dhanjit/vertical-chess-board/README.md

# Vertical Wall Chess Board

A chess board that **hangs on the living-room wall** like art and plays
vertically — with two signature mechanics:

- 🔄 **Rotates 180° based on whose turn it is**, so the player to move always
  sees the board from their own side.
- 🌍 **Pieces stay upright by gravity** — each piece hangs on a pivot and is
  bottom-heavy *by shape* (solid below the pivot, hollow above it — nothing
  glued in), so as the board turns, every piece self-levels and is never
  upside-down.
- 🧲 **Magnetic pieces** grip a steel-sheet vertical playing face.
- 🎛️ **The piece design is a *choice*, not one answer** — two piece styles and
  two ways of hanging them sit side by side in the repo, each a one-line
  selector, and more can be added. Compared measure-for-measure in
  [`docs/PIECE_DESIGNS.md`](docs/PIECE_DESIGNS.md).
- 🖨️ **3-D printable** — parametric models, ready for any FDM printer.
- 🌠 **Aspirational (later):** the board plays *you* (auto-mover) and is
  controllable from a phone app — researched, but deliberately out of the
  initial focus. The near-term goal is the hand-played manual board.

This repo is the **single source of truth** for building it: designs, models,
electronics, the game brain, and the plan.

## Repo map

```
README.md              ← you are here
CLAUDE.md              ← context for AI sessions working on this repo
docs/
  OVERVIEW.md          ← ⭐ one-page what / why / how + the plan (share this)
  START_HERE.md        ← new to printing? plain-language first steps + print spec
  PROJECT_REVIEW.md    ← honest review of the idea + re-scoped beginner plan
  SOURCING_BANGALORE.md← where to print + buy parts locally (₹)
  OPEN_SOURCE.md       ← existing open-source projects to reuse (don't reinvent)
  AUTO_MOVER_ANALYSIS.md← why a vertical self-moving board is hard (physics)
  AUTO_MOVER_DESIGN.md ← how to actually build one (EPM matrix, prior art, prototypes)
  DESIGN.md            ← how it works (the two mechanics, magnets, sensing)
  PIECE_DESIGNS.md     ← the piece variants side by side — open this to choose
  GOALS.md             ← vision, phases, roadmap, decisions to lock
  BOM.md               ← shopping list per phase
  BUILD_GUIDE.md       ← step-by-step assembly (start at Phase 0!)
  ELECTRONICS.md       ← powered rotation, sensing, auto-mover, firmware plan
hardware/              ← parametric OpenSCAD models (+ Makefile → STLs)
  common.scad          ← ⭐ edit this to resize the whole board; holds the two
                          variant selectors (piece_style, pivot_type)
  gravity_gimbal.scad  ← the self-righting pivot — ALL the architectures
  pieces.scad          ← the mechanism that turns a silhouette into a piece
  styles/              ← the artwork: one file per piece style
    monolith.scad      ←   an invented design language
    familiar.scad      ←   the vocabulary everyone knows (default)
  board_panel.scad     ← 8×8 surface: steel-sheet face + hall-sensor bores
  frame.scad           ← bezel
  rotation_hub.scad    ← wall plate + turntable + drive
software/engine/       ← the brain (plain JS, no deps)
  chess.js             ← full rules engine (perft-verified)
  ai.js                ← negamax + alpha-beta opponent
app/                   ← control-app spec (future)
```

## Start here

**Want the whole project on one page?** Read
[`docs/OVERVIEW.md`](docs/OVERVIEW.md) — what it is, why we're building it, and
the plan. It's the doc to share with anyone new, including whoever prints the
parts.

**New to 3D printing / electronics? Read [`docs/START_HERE.md`](docs/START_HERE.md)
next** — a plain-language guide (no experience needed) with a print spec for
whoever runs the printer and a simple shopping list. Then
[`docs/PROJECT_REVIEW.md`](docs/PROJECT_REVIEW.md) reviews the idea and lays
out a realistic staged plan, and [`docs/SOURCING_BANGALORE.md`](docs/SOURCING_BANGALORE.md)
covers where to print and buy parts in Bengaluru.

Then, when you want the deeper detail:
1. [`docs/DESIGN.md`](docs/DESIGN.md) — the concept and mechanics.
2. [`docs/GOALS.md`](docs/GOALS.md) — phases and the decisions to lock.
3. **Phase 0** in [`docs/BUILD_GUIDE.md`](docs/BUILD_GUIDE.md): print one
   gravity gimbal + one piece and prove the self-righting magnet mechanic
   before committing to a full set.

## Status

| Area | State |
|---|---|
| Rules engine + AI | ✅ implemented, perft-verified (20 / 400 / 8902) |
| Parametric models (pieces, gimbal, panel, frame, hub) | ✅ drafted, ready to render/tune |
| Docs (design, goals, BOM, build, electronics) | ✅ drafted |
| Anything physically built | ⬜ over to Phase 0 |

Phased so **Phase 1 alone is a complete, beautiful manual board** you can hang
and play; later phases add powered rotation and sensing, and — aspirationally —
an auto-mover and app, without a rebuild.

## Building the STLs

```
cd hardware && make          # needs OpenSCAD; outputs to hardware/stl/
```

## Using the brain

```
node -e 'const {Chess}=require("./software/engine/chess.js"); const g=new Chess(); console.log(g.legalMoves().length)'   # 20
```
