dhanjit/vertical-chess-board/docs/OVERVIEW.md

# Project Overview — Vertical Wall Chess Board

**One page: what this is, why we're building it, how it works, and the plan to
get there.** If you're new to the project — or about to print the parts — read
this first. Everything else in the repo is detail that hangs off this page.

---

## What it is

A real chess board that **hangs on the living-room wall like a piece of art**
and plays vertically. Three things make it special:

- 🔄 **It rotates 180° to face whoever's turn it is** — the player to move
  always sees the board from their own side.
- 🌍 **Pieces stay upright by gravity** — each piece hangs on a pivot and is
  bottom-heavy *by shape* (solid below the pivot, hollow above it), so as the
  board turns, every piece self-levels like a pendulum and is never
  upside-down.
- 🧲 **Pieces are magnetic** — they grip the board's vertical steel face, so
  they hold on and slide square to square.

It's **3-D printed** from parametric models (a few numbers resize the whole
board) plus a short list of off-the-shelf parts — magnets, a thin steel
sheet, a turntable bearing, a wall cleat.

## Why we're building it

- A chess board that's also **wall art** — quietly beautiful when idle,
  a little bit magical in play.
- The combination — **face-the-player rotation** *and* **gravity-upright
  pieces** on a **vertical** board — is genuinely new. Smart/auto boards on the
  market lie flat; none do the self-righting wall trick.
- It's an achievable, satisfying **making project**. The first version needs
  **no electronics and no coding** — just printed parts, magnets, and glue —
  so it's a real object on the wall long before any of the fancy stuff.

## How it works (30 seconds)

<p align="center">
  The two signature mechanics. Left: the board rotates 180 degrees each turn on a central turntable, so the player to move always sees it from their side. Right: each piece hangs on a pivot with a heavy base, so gravity keeps it upright like a pendulum however the board is turned.
</p>

- The board is a **vertical plane on a central turntable**. Its playing face
  is a **thin steel sheet**, and a **magnet** grips it directly, so pieces hold
  on and glide square to square — the same hold every commercial magnetic wall
  set uses. In the default arrangement that magnet sits in a small printed
  **hub puck** behind the piece, under a **felt disc**; the alternative puts it
  inside the piece itself (next bullet).
- Each piece body hangs on a **low-friction pivot** and is **solid below that
  pivot and hollow above it** — a pendulum that always points up, no matter how
  the board is turned. Nothing is glued or weighted into a piece.
- **The piece design is a *choice*, not a single answer.** Two piece styles
  (what a piece **looks like**) and two ways of hanging them (where the
  **magnet** lives) are kept in the repo side by side, selectable with one line
  each, and more approaches are expected. The defaults — the familiar-looking
  set on a hub-puck pivot — are what the rest of this page describes. If you're
  deciding what to print, the comparison is
  [`PIECE_DESIGNS.md`](PIECE_DESIGNS.md).
- *(Later, optionally)* a motor spins the board, hall sensors behind each
  square read the position, and the built-in chess engine follows and
  validates the game.

<p align="center">
  Cross-section through one square. A magnet in the piece hub, capped with a felt disc, grips the thin steel sheet directly, holding the piece on the vertical board. A small hole in the sheet at the square's centre is open air, so a hall sensor sitting flush in the printed wall behind it reads the pi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
</p>

Full engineering detail: [`DESIGN.md`](DESIGN.md).

---

## The plan — how we get there

Build in **phases**, and **each phase is a complete, usable thing on its own**.
You can stop after any of them and have something real.

```mermaid
flowchart LR
    P0["<b>Phase 0</b><br/>Prove the magic<br/><i>~1 evening · ~₹500</i>"]
    P1["<b>Phase 1</b> ⭐<br/>Manual wall board<br/><i>hang &amp; play by hand</i>"]
    P2["<b>Phase 2</b><br/>Powered rotation<br/>+ sensing"]
    P3["<b>Phase 3</b><br/>Board plays you<br/>(auto-mover)"]
    P4["<b>Phase 4</b><br/>App &amp; polish"]
    P0 --> P1 --> P2 -.-> P3 -.-> P4
    P1 -. "stop here &amp;<br/>be delighted" .-> DONE([complete board])
    classDef focus fill:#1a7f37,stroke:#0d4020,color:#ffffff;
    classDef optional fill:#9a6700,stroke:#5c3d00,color:#ffffff;
    classDef asp fill:#8250df,stroke:#432c85,color:#ffffff;
    classDef done fill:#eaf6ee,stroke:#1a7f37,color:#0d4020;
    class P0,P1 focus;
    class P2 optional;
    class P3,P4 asp;
    class DONE done;
```

**Legend:** 🟩 focused on now · 🟧 optional, later · 🟪 aspirational (parked).
Solid arrows are the path we're building; dotted ones are further out.

| Phase | What you get | Where it sits |
|---|---|---|
| **Phase 0 — Prove the magic** | Print *one* pivot + *one* piece; confirm a piece **sticks** to a vertical steel surface and **stays upright** when you spin it. ~1 evening, ~₹500. | ✅ **do this first** — a GO/NO-GO gate before printing a whole set |
| **Phase 1 — Manual wall board** ⭐ | The full 32-piece set + board panel + frame + turntable, hung on the wall and **spun by hand** each turn. No electronics, no code. | 🎯 **this is the goal we're focused on** — and, for most people, the finished project |
| **Phase 2 — Powered + sensing** | A motor rotates the board on a button press; hall sensors read the pieces so the board follows the game and flags illegal moves. Your first electronics. | 🟡 optional, later |
| **Phase 3 — The board plays you** | An auto-mover physically moves its own pieces and plays you (via Stockfish). | 🌠 **aspirational — not a current focus** (see below) |
| **Phase 4 — App & polish** | Phone app: difficulty, hints, clocks, online play, sound/LED. | 🌠 aspirational — later |

> Two docs expand this same path: [`PROJECT_REVIEW.md`](PROJECT_REVIEW.md)
> breaks it into finer beginner **stages A–E** with an honest difficulty/risk
> read, and [`GOALS.md`](GOALS.md) is the full technical roadmap with the open
> design decisions. This table is the summary they both detail.

---

## What we're focused on right now

**Focus: get to a hung, hand-played manual board (Phase 0 → Phase 1).** That is
a complete, beautiful object and, for most builders, the whole project. The
near-term repo work — printable parts, BOM, build steps — all serves this.

**Aspirational — deliberately *not* the current focus:**

- **The auto-mover** (Phase 3 — a board that moves its own pieces and plays
  you). On a *vertical* board this is genuinely hard: the steel sheet that
  **holds** pieces up also **shields** the magnet that would **move** them, so
  it's a **different machine**, not a bolt-on. We've researched *how* it could
  work and *why* it's hard — [`AUTO_MOVER_ANALYSIS.md`](AUTO_MOVER_ANALYSIS.md)
  (the why) and [`AUTO_MOVER_DESIGN.md`](AUTO_MOVER_DESIGN.md) (the how) — and
  we're parking it as a **someday** goal.
- **The phone app** (Phase 4) is a similarly later, aspirational add.

**Good news:** nothing built for Phase 1 is wasted if auto-play is ever
pursued — the pieces, the chess brain, and most of the frame carry straight
over. So there's no penalty for building the manual board first and deciding on
the rest later.

---

## If you're the one printing the parts

You don't need to understand the whole project to print — but if you want the
context (what this is, why, what you're printing toward), it's right here:

1. **This page** — what it is, why we're building it, and the plan *(the what &
   why)*.
2. [`../hardware/README.md`](../hardware/README.md) — how to turn the `.scad`
   models into STLs, and the print settings *(the how)*.
3. [`START_HERE.md`](START_HERE.md) — a plain-language, **no-experience-needed**
   walk-through, including a **print spec** (what to render first) and the
   small shopping list.

```mermaid
flowchart TD
    A["📖 <b>OVERVIEW.md</b><br/><i>what · why · the plan</i>"]
    A --> B["🖨️ <b>hardware/README.md</b><br/><i>render STLs + print settings</i>"]
    A --> C["🌱 <b>START_HERE.md</b><br/><i>plain-language walkthrough</i>"]
    B --> D(["Print a <b>test batch</b><br/>1 gimbal + 1 pawn"])
    C --> D
    D --> E(["Prove it → print the full set"])
    classDef hub fill:#0969da,stroke:#0a3069,color:#ffffff;
    classDef step fill:#eef2f6,stroke:#57606a,color:#1f2328;
    classDef goal fill:#eaf6ee,stroke:#1a7f37,color:#0d4020;
    class A hub;
    class B,C step;
    class D,E goal;
```

**Short version:** render a **test batch first** — one gravity gimbal + one
**pawn** (the cheapest print in the set) — prove the piece sticks and
self-rights, *then* print the full set.

---

## The rest of the repo, at a glance

| Doc | What's in it |
|---|---|
| [`START_HERE.md`](START_HERE.md) | Plain-language first steps + print spec (start here if you're new to printing) |
| [`DESIGN.md`](DESIGN.md) | How the two mechanics, magnets, and sensing actually work |
| [`PIECE_DESIGNS.md`](PIECE_DESIGNS.md) | The piece styles and pivot architectures **side by side** — measured, with costs — and how to add another |
| [`GOALS.md`](GOALS.md) | Full technical roadmap (Phases 0–4) + open decisions to lock |
| [`PROJECT_REVIEW.md`](PROJECT_REVIEW.md) | Honest difficulty/risk read + beginner staged plan (A–E) |
| [`BOM.md`](BOM.md) | Shopping list per phase |
| [`BUILD_GUIDE.md`](BUILD_GUIDE.md) | Step-by-step assembly (start at Phase 0) |
| [`SOURCING_BANGALORE.md`](SOURCING_BANGALORE.md) | Where to print + buy parts locally (₹) |
| [`OPEN_SOURCE.md`](OPEN_SOURCE.md) | Existing projects to reuse instead of reinventing |
| [`ELECTRONICS.md`](ELECTRONICS.md) | Powered rotation + sensing plan (Phase 2) |
| `AUTO_MOVER_*.md` | 🌠 Aspirational auto-play research (Phase 3) |
| [`../hardware/README.md`](../hardware/README.md) | The OpenSCAD models + how to render STLs |
| [`../software/engine/README.md`](../software/engine/README.md) | The chess brain (rules engine + AI) |

## Status

| Area | State |
|---|---|
| Rules engine + AI | ✅ implemented, perft-verified |
| Parametric models (pieces, gimbal, panel, frame, hub) | ✅ drafted, ready to render/tune |
| Docs (design, goals, BOM, build, electronics) | ✅ drafted |
| Anything physically built | ⬜ next step is **Phase 0** |

**Next real-world step:** Phase 0 in [`BUILD_GUIDE.md`](BUILD_GUIDE.md) — prove
the gravity-magnet piece before printing a full set.
