dhanjit/vertical-chess-board/hardware/reference/familiar_v2/familiar_v2_knight.step

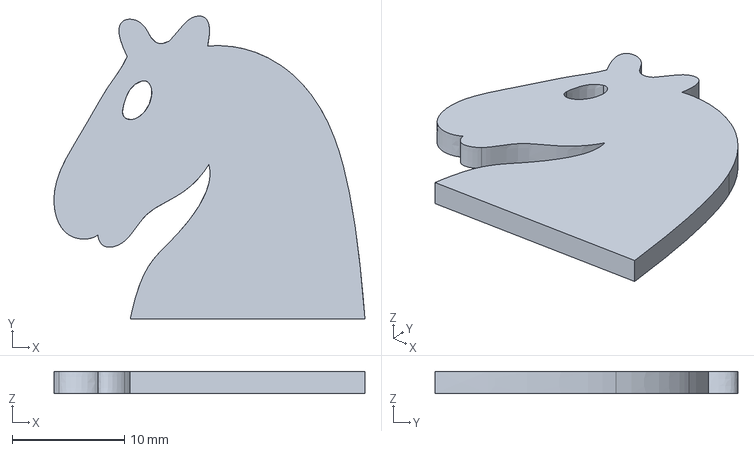
[picture p1: CAD file, 2026-10-16]
hardware/reference/familiar_v2/familiar_v2_knight.step
27.7 x 26.9 x 2.00 mm
