dhanjit/vertical-chess-board/(commit log)

2026-07-07 Set up repo as the build hub for the physical wall chess board
    Turn this repo into the single source of truth for building a real,
    wall-mounted vertical chess board with two signature mechanics:
    - the board rotates 180 degrees based on whose turn it is
    - pieces stay upright by gravity (pendulum pivot) and hold magnetically
    Contents:
    - hardware/ parametric OpenSCAD models (one shared common.scad drives
    all dimensions): self-righting gravity gimbal, flat silhouette pieces,
    8x8 board panel with per-square steel-washer holders + hall-sensor
    pockets, bezel frame, and the wall-mount turntable + drive. Makefile
    renders every part to STL.
    - docs/ DESIGN (how the mechanics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
    [board_panel.scad, common.scad, frame.scad, gravity_gimbal.scad, pieces.scad, rotation_hub.scad]
2026-07-07 Add beginner-friendly START_HERE guide for a first-time builder
    The owner is new to 3D printing/electronics and just has a friend with a
    printer. Add docs/START_HERE.md: plain-language, no-experience-needed guide
    covering what actually has to happen for the hand-played board, a cheap
    one-evening Phase 0 test, a copy-paste message to send the printer friend,
    and a simple shopping list. Point the README there first and record the
    beginner context in CLAUDE.md so future guidance stays approachable.
    Claude-Session: https://claude.ai/code/session_01B1iMKWHiH5fLS8i66Q5nnx
2026-07-07 Add project review, staged beginner plan, and Bengaluru sourcing
    Respond to "plan everything properly, review the idea, review the phases
    (I'm a first-timer), look at Bangalore options":
    - docs/PROJECT_REVIEW.md: honest review of the idea; feature-by-feature
    difficulty/risk read; the vertical-board vs. auto-mover design conflict
    called out plainly; a re-scoped 5-stage plan (A prove the mechanic ->
    B manual board -> C motorize -> D sense -> E auto-play/app) with clean
    stopping points; simplification fallbacks; rough costs.
    - docs/SOURCING_BANGALORE.md: local + online options for printing (friend's
    printer vs. iamRapid/Makenica services vs. makerspaces) and parts (SP Road,
    Robu.in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
2026-07-07 Add OPEN_SOURCE.md: existing projects to reuse instead of building from scratch
    Answer "check online for open-source software that does most of the work":
    survey and map mature open-source projects onto our phases so the electronic
    work becomes porting, not inventing. Only our mechanical design (vertical,
    rotating, gravity-upright pieces) is novel; sensing, opponent engine, self-
    moving gantry, and online play are all solved.
    - Brain/opponent: Stockfish (+ stockfish.js, chess.js, python-chess, PicoChess)
    - Phase 2 sensing: Open-Chess (MIT), eChess, autopatzer, chesslr, tutorials
    - Phase 3 auto-mover: Imperium (CoreXY + hall + electromagnet + FluidNC), Mags,
    plus GRBL/Marlin motion firmwar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
2026-07-08 Add researched AUTO_MOVER_ANALYSIS.md: why vertical self-moving is hard
    Deep-dive (with sources) into why the horizontal auto-chess trick breaks on a
    vertical board, and how it could still work:
    - The two colliding facts: vertical hold is 100% magnetic (friction from a
    magnetic normal force), while the mover must couple through the board.
    - Three stacked conflicts: (1) hold-strength and shielding are the SAME knob
    (a ferromagnetic backing that holds also shields the mover); (2) the hold is
    exactly the friction the mover must overcome; (3) hold must be
    everywhere-always but the gantry mover is one point.
    - Corrected the shielding nuance (thin plate can bridge/concentrate flux;
    thic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
2026-07-08 Add AUTO_MOVER_DESIGN.md: how to actually build a vertical auto-mover
    Deep, sourced design exploration answering "how could vertical auto-move work?"
    Complements AUTO_MOVER_ANALYSIS.md (why it's hard) with a constructive plan:
    - Requirements decomposition (hold 32 idle continuously + fail-safe through
    blackout + move one + do both without conflict + heat/cost/thickness).
    - Prior art that proves grid-actuation moves magnets on a surface: MIT Actuated
    Workbench (2002), Madgets (2010, even lifts), multi-magnet coil-array control.
    - Four architectures compared (coil matrix / EPM matrix / hybrid / reclined
    gantry). Recommends the ELECTROPERMANENT-MAGNET (EPM) matrix: holders are the
    move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
2026-07-14 Fix build-blocking hardware/doc defects; depersonalize for sharing
    Multi-agent review of the whole plan before Phase 0, then every confirmed
    finding fixed and re-verified by rendering each part in OpenSCAD.
    Hardware (geometry now renders clean + manifold; pieces verified single-body):
    - pieces: blind weight pocket (was a through-hole), bosses around the pivot
    bore and weight pocket so the pawn head / king cross are one connected body
    (were floating islands); pivot_frac moved to common.scad.
    - gravity_gimbal: snap cap reworked to snap over a flared axle tip with three
    flex slits (old cap subtracted a groove -> never engaged; axle was necked to
    a break point).
    - rotation_hub: ring gea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
    [board_panel.scad, common.scad, frame.scad, gravity_gimbal.scad, pieces.scad, rotation_hub.scad]
2026-07-14 Depersonalize build docs: remove "give this to a friend" framing
    The docs assumed a specific reader who would hand the .scad files to a
    friend with a printer. Reframe for a proper shared repo — written for the
    builder generally, with the real printing options (own printer, borrowed,
    print service, or makerspace).
    - START_HERE.md: intro + how-it-works reframed; "Copy-paste this to your
    friend" message becomes a neutral "Print spec — for whoever runs the
    printer" (keeps all print settings, adds full-set pointer).
    - SOURCING_BANGALORE.md: "friend's printer" -> "your own or a borrowed
    printer" throughout.
    - PROJECT_REVIEW.md: drop the "you have a friend with a printer" premise;
    cost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
2026-07-14 Add one-page OVERVIEW.md; scope auto-mover as aspirational
    Consolidate the fragmented plan (GOALS phases, PROJECT_REVIEW stages,
    START_HERE first-steps) into a single shareable entry doc, and demote the
    auto-mover from "the default plan" to an explicitly aspirational, not-current
    focus across every doc.
    New:
    - docs/OVERVIEW.md — one page: what it is, why, how it works, the phased plan,
    what's in focus now (manual board) vs aspirational (auto-mover, app), a
    "for whoever's printing" pointer, and a doc map. This is the doc to share
    with anyone new, including whoever prints the STLs.
    Wired as the entry point from README, START_HERE, GOALS, PROJECT_REVIEW,
    and CLAUDE.md.
    Auto-mover ->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
2026-07-14 Make OVERVIEW.md visual: mechanics/cross-section SVGs + Mermaid roadmap
    Add four version-controlled visuals to the shareable overview (all render
    natively on GitHub — no binary assets):
    - docs/images/mechanics.svg — the two signature mechanics (180° rotation on
    the turntable; the gravity-upright pendulum piece).
    - docs/images/hold.svg — cross-section of one square: magnet grips the steel
    washer through the front wall; hall sensor reads through the washer's hole.
    - Mermaid roadmap flowchart, colour-coded focus (green) / optional (amber) /
    aspirational (purple), with a legend.
    - Mermaid "reading path" for whoever prints: OVERVIEW -> hardware/README /
    START_HERE -> test batch ->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
2026-07-14 Parametrize M3 hole dims; fix four doc inconsistencies
    Hardware: move the M3 fastener hole diameters into common.scad
    (m3_clear=3.2, m3_tap=2.9) and reference them from rotation_hub.scad,
    frame.scad, and board_panel.scad instead of repeating literals. Values
    are unchanged, so geometry is identical; this restores the "one place
    to change a dimension" rule from CLAUDE.md. All five touched part
    variants render warning-free.
    Docs: fix four wording inconsistencies surfaced by a project sweep —
    * D1-D6 pointed at DESIGN.md sec 8, which only covers D1-D5; D6 now
    points to the AUTO_MOVER docs.
    * Phase 4 heading now carries the aspirational marker (matches M4,
    OVERVIEW, CLAUDE).
    * Ph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
    [board_panel.scad, common.scad, frame.scad, rotation_hub.scad]
2026-08-02 Reinforce axle post root; add anti-clamp axial float
    - 45-deg fillet cone at the axle post root (its layer-line-weak point
    under a sideways knock); piece bores get a matching countersink so
    bodies still seat flush.
    - axle_len 10 -> 10.5: ~0.7 mm axial float so print tolerance can't
    clamp the body between hub and cap and stop it rotating.
    [common.scad, gravity_gimbal.scad, pieces.scad]
2026-08-02 Switch piece attachment to steel-sheet face (locks D7, D2)
    Adopt the proven attachment every commercial magnetic wall set uses:
    a thin steel sheet glued to the panel front, piece magnets gripping it
    directly, felt disc per hub as the glide/drag tuner. Replaces the
    unproven buried-washer grip through a 2.5 mm wall.
    - board_panel.scad: sensor through-bores + sheet DXF export
    (QUARTER="sheet_dxf", make sheet); engraved squares move to
    paint/vinyl on the sheet; washer pockets gone.
    - common.scad: washer_*/sensor_h retired; sheet_thk/sheet_hole added.
    - Phase-2 sensing reads through a small laser-cut hole per square.
    - Docs + BOM + hold.svg updated repo-wide; D7 recorded in GOALS.md,
    D2 lo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
    [board_panel.scad, frame.scad]
2026-08-06 Redesign the pieces around the physics; lock board size at 55 mm
    The self-righting mechanic reduces to one equation:
    sin(lean) = mu * r / d
    with r the bore radius and d the drop from pivot to centre of mass. Mass
    cancels out entirely, which invalidates the old approach: a glued-in lead
    slug did nothing for how straight a piece hangs, and made the design
    material-dependent (a fixed slug moves a light FDM body further than a
    dense resin one, so bench tuning did not transfer). Ballast is removed.
    Bottom-heaviness is now shaped in - solid below the pivot, hollow above -
    so the piece is one material and density cancels. A cheap PETG test print
    now behaves identically to the final resin part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
    [common.scad, gravity_gimbal.scad, pieces.scad]
2026-08-10 Make piece style and pivot architecture selectable variants
    The design was converging on one answer when what is actually wanted is
    several, kept side by side and compared. More approaches are expected, so
    the point of this change is that adding the next one is one new file and
    one enum value rather than a rewrite.
    Two independent axes, both in common.scad:
    piece_style = "familiar"; // "monolith" | "familiar"
    pivot_type = "pin"; // "pin" | "magnet"
    piece_style is the artwork. Each style is a file in hardware/styles/
    exposing exactly silhouette2d(t), pheight(t) and drains(t); artwork
    constants stay inside it, because they are nominal pre-scale millimetres
    and putting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
    [common.scad, familiar.scad, gravity_gimbal.scad, monolith.scad, pieces.scad]
2026-08-11 Add a Windows build script; the Makefile alone was unusable here
    The documented entry point was `cd hardware && make`, and on the machine
    this is being developed on that fails twice over: there is no `make`
    anywhere (not in Git Bash, no Cygwin, no MSYS2, no chocolatey), and the
    OpenSCAD installer does not put itself on PATH, so even the direct
    `openscad ...` lines in the docs do not run as written. The Makefile was
    never wrong, it was just addressed to a machine nobody here has.
    hardware/build.ps1 covers the same targets with the same outputs and the
    same variant handling, and finds OpenSCAD itself. Tested end to end:
    pieces, gimbal, variant, matrix, board_test, mech, clean.
    Three Windows-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
2026-08-20 Add prints/: pre-rendered per-variant output with instructions
    One folder per style x pivot combination (plus common/ for the
    variant-independent board and frame parts), each with a README covering
    files, shopping list, assembly, the Phase-0 test, and that combination's
    modelled numbers. STLs themselves stay gitignored; the folder rebuilds
    from source with the commands in prints/README.md.
2026-08-20 Add "bearing" as a third pivot architecture
    An MR63ZZ (O3 x O6 x 2.5) pressed into the piece's back face replaces the
    greased sliding bore; hub puck, dowel, magnet, felt and cap stay identical
    to "pin". Rolling friction parks every piece at ~0 deg regardless of mu,
    making this the documented fallback if the Phase-0 ten-flip test measures
    friction far above the assumed 0.08. The honestly-stated open cost: the
    grease was also the damper, so nothing damps the swing any more --
    ring-down time is this architecture's first Phase-0 question, with the
    face-film grease smear recorded as the tunable retrofit.
    The original D9 rejection is updated, not reversed: its size objection
    (a O9 boss "wider tha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
    [common.scad, gravity_gimbal.scad]
2026-09-01 chore: pin line endings to LF via .gitattributes
    No content change — this repository was already LF. This fixes the
    policy in place so it cannot drift.
    core.autocrlf is per-machine and had regressed to true on the Windows
    box. `* text=auto` alone is not sufficient: core.eol defaults to
    native, so Windows still checks out CRLF. eol=lf pins both sides, which
    this tree needs because it is opened from both Windows and WSL.
    Windows-native script types keep CRLF via explicit exceptions.
2026-09-10 fix(build.ps1): real failure detection, and stop leaking the caller's cwd
    Post-merge review of #8, findings 1, 2, 4, 5, 13, 29 and 31.
    1 The GUI-exe fallback made failure detection meaningless. openscad.exe is
    the WINDOWS-subsystem build: it detaches, $LASTEXITCODE comes back empty,
    and the first render throws "OpenSCAD failed ()" on a SUCCESS while a real
    failure passes against a stale STL. Reproduced on 2021.01 before the fix.
    Now: always resolve to the .com console shim when one sits next to the
    .exe (including a path handed in with -OpenScad), and if there genuinely
    is no .com, run the .exe through Start-Process -Wait -PassThru and read
    .ExitCode off the process. -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
2026-09-10 fix(Makefile): stop masking mid-loop failures; check STYLE/PIVOT are real
    Post-merge review of #8, findings 3, 5, 6, 13 and 29.
    3 A shell for-loop reports only its LAST iteration's status, and none of the
    four loop bodies had `|| exit 1`. `make matrix` could exit 0 with a whole
    variant sub-build missing. Added inside the body of all four (pieces,
    variant, matrix, board), not after `done`, which is where it does nothing.
    6 `variant` only checked STYLE/PIVOT for non-emptiness, so a typo created
    stl/<typo>_pin/ and burned six failing renders before anything said so.
    Both are now checked for MEMBERSHIP of $(STYLES)/$(PIVOTS), before mkdir.
    29 `matrix` is pivot-major and passe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
2026-09-10 fix(scad): reject an unknown PART, and assert the stack-ups the comments claim
    Post-merge review of #8, findings 7-10, 12, 21-24, 26, 27, 34-38.
    CORRECTNESS
    7 An unknown PART was not rejected anywhere. monolith's trailing `else`
    silently drew a KING for any name at all -- exit 0, a plausible STL, the
    wrong piece -- and familiar fell off the end of its chain and drew nothing.
    The style and pivot axes both had loud asserts; PART had none. Now:
    PIECE_TYPES in pieces.scad with an assert against it, monolith's last
    branch named `else if (t == "king")` with an assert underneath, and the
    same assert on familiar's dispatcher.
    8 pivot_frac * H <= square_size / 2 is the one rela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
2026-10-12 Add familiar v2: the CC0 reference set as plain STEP
    The six flat plates `familiar` was drawn after (Thingiverse thing:7152789)
    turn out to be public domain (CC0 1.0, checked on the listing 2026-10-11).
    That reverses the 2026-08-10 rule against shipping them, which existed only
    because the licence was unknown.
    They ship in hardware/reference/familiar_v2/ as editable STEP: outlines
    rebuilt as lines + B-splines within 0.005 mm of the source, original size,
    2 mm thick, no pivot, no holes, no hollow. Reference artwork only -- not a
    piece_style, and nothing in the SCAD pipeline reads it. PIECE_DESIGNS.md
    records what still stops it hanging on the board (no material at the
    bishop/knight pivot, sl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
2026-10-16 Adopt familiar v2 as the base piece design (D12 artwork half)
    familiar v2 is now the adopted base design for the pieces. It is still
    reference STEP, not a piece_style, so the files keep defaulting to
    familiar + pin until it becomes one. The pivot half of D12 stays open.
    Records the decision in GOALS D12, DESIGN §8, CLAUDE.md, README,
    START_HERE and the familiar_v2 README. PIECE_DESIGNS gains the first
    bearing prototype (queen, 2026-10-15) with balance numbers measured from
    the STEP: as drawn its centre of mass hangs only 0.09 mm below the
    bearing; three variants reach 1.33-1.49 mm. It also notes that a centred
    pivot (D8) puts the bearing seat into the crown notches on this queen.
    Refs #14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
